Ian-Blockmans/efuse/aftbeeldingen/home_test_opstelling.png

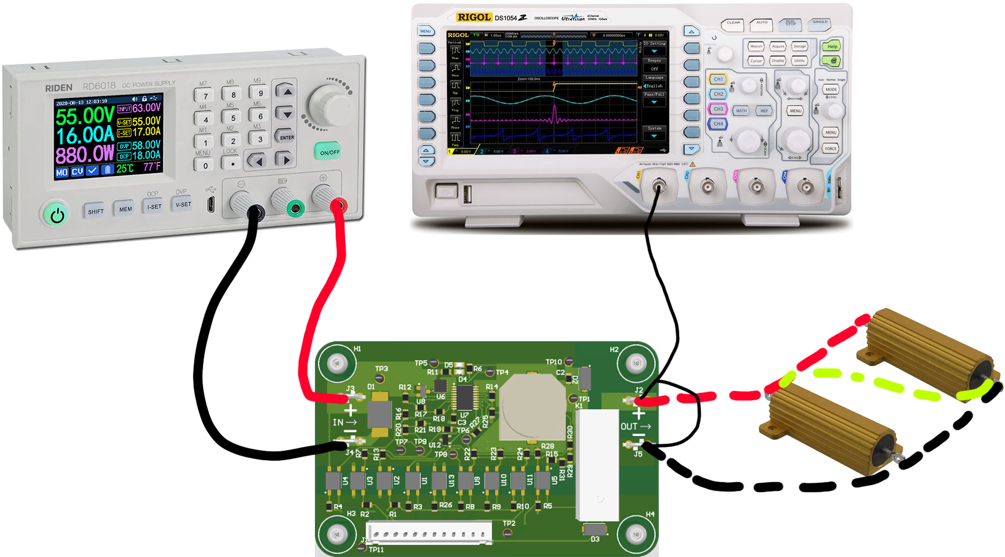
aftbeeldingen/home_test_opstelling.png
