Ian-Blockmans/efuse/aftbeeldingen/AS_test.png

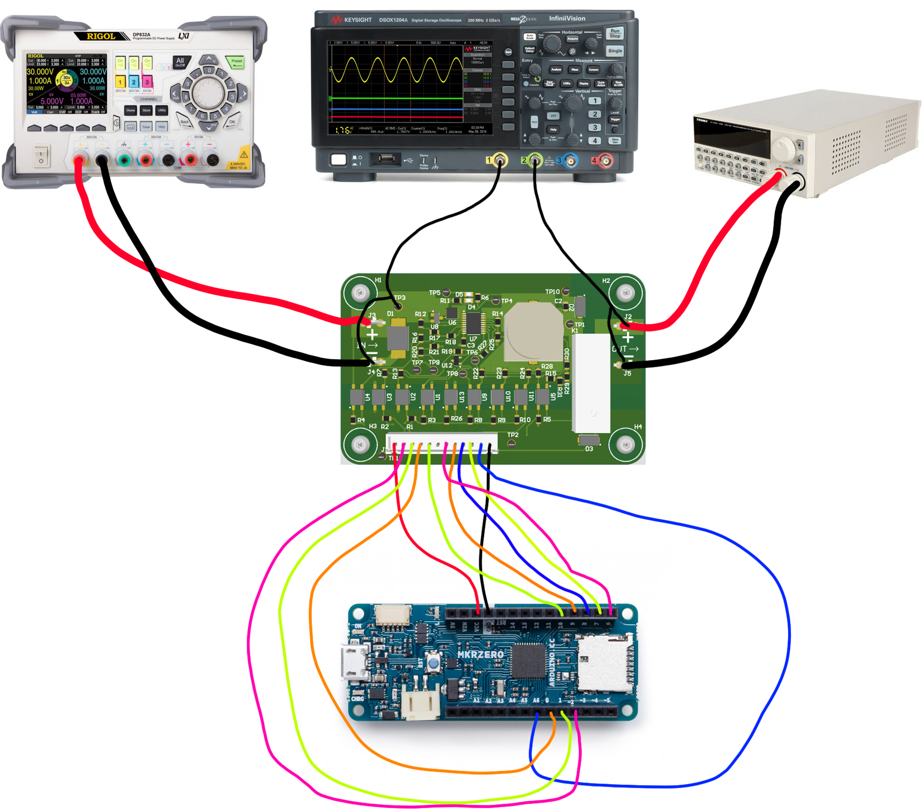
aftbeeldingen/AS_test.png
