Ian-Blockmans/efuse/README.md

# Bachelor proef: Efuse
Een second layer protection voor testopstellingen bij Antwerp Space. Zie Eindwerk-Ian-Blockmans-r0741829.pdf voor meer info
