Ian-Blockmans/efuse/efuse 2021.docx

# Voorwoord

Typ hier het voorwoord

# Samenvatting

# Inhoudstafel

# Inleiding

Typ hier de inleiding

# 1 blokschema

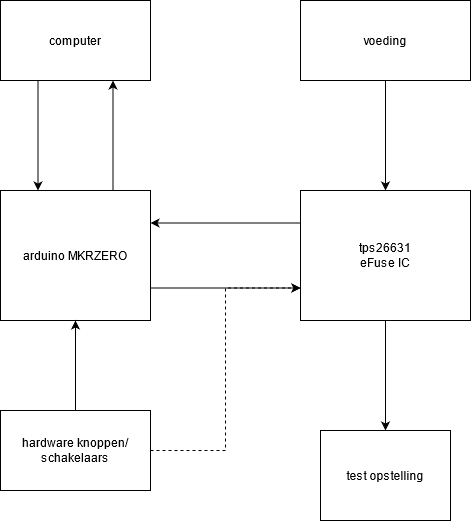
[picture p14: figure]

eFuse-LCL13

# 2 Software

## 2.1 IDE’s

Bruikbare IDE’s voor Atmel SAM (arduino mkrzero):

| Microchip MPLAB | PlatformIO | Arduino | IAR Embedded Workbench
Prijs | Gratis | Gratis | Gratis | Niet vermeld je moet een quote vragen
Editor | custom | VSCode, … | Custom(arduino ide 2 is bijna identiek aan VSCode) | Custom of Eclipse
Debugging | Ja | Ja | Alleen in V2 momenteel in beta | Ja
Unit Testing | Mogelijk maar niet veel documentie. | Ingeboud. Goede documentatie. | Mogelijk met extra software vooral voor arduino bordjes | Extern
Code Coverage | Ja | Extern | Extern | Extern
Open source | Nee | Ja | Ja | Nee
Extras | MPLAB Code Configurator(GUI controller configurator tool), microchip HAL library. | Support voor arduino en veel andere platforms en libraries. | Arduino libraries. | Functional safetey certificcation, …

Mijn keuze hier is PlatformIO. Heeft de meeste functionaliteit en is gratis.

## 2.2 User interface

### 2.2.1 Modbus over virtual com port

Voor communicatie met een computer is er gekozen voor Modbus RTU. Dit is een gestandaardiseerd protocol. Hierdoor kan ik gemakkelijk data van de eFuse binnen nemen en data sturen naar de eFuse.

#### 2.2.1.1 Coils

Adres | Coil name | Function
1 | ON/OFF | De efuse aan en uit zetten.
2 | LCL-class 1 | Maximumstroom 1.4A spanning van 22V tot 38V
3 | LCL-class 2 | Maximumstroom 2.8A spanning van 22V tot 38V
4 | LCL-class 3 | Maximumstroom 4.2A spanning van 22V tot 38V
5 | 12V | Maximum spanning 12V
6 | 5V | Maximum spanning 5V
7 | Arduino led | Led van de arduino

Als een LCL-class coil op 1 wordt gezet worden de andere op 0 gezet. Als je een instelling op 0 zet wordt de efuse uitgeschakeld.

#### 2.2.1.2 Registers

… temprature?

#### 2.2.1.3 Inputs

Adres | Input name | Function
1 | Pgood | Is de eFuse ON
2 | Fault | Er is een fout opgetreden (overvolt, undervolt of overcurrent)

#### 2.2.1.4 Finite state machine modbus

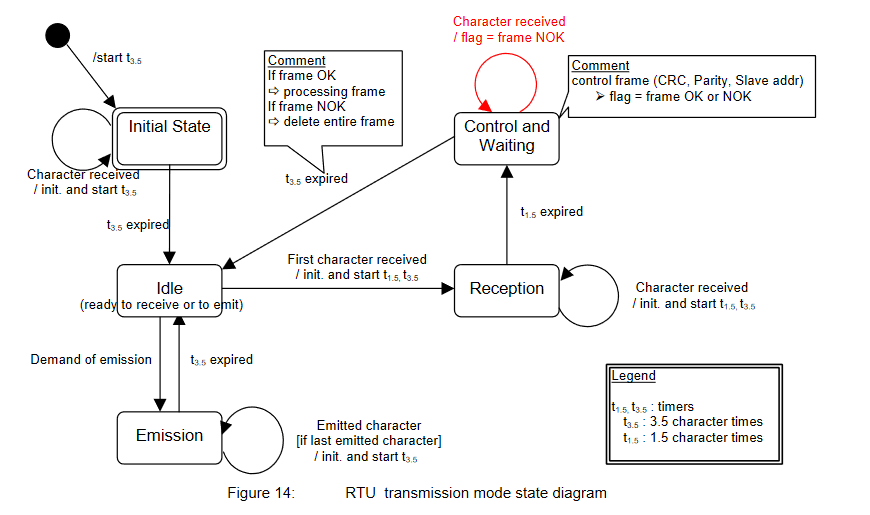
[picture p15: figure]

#### 2.2.1.5 Control and wait flowchart

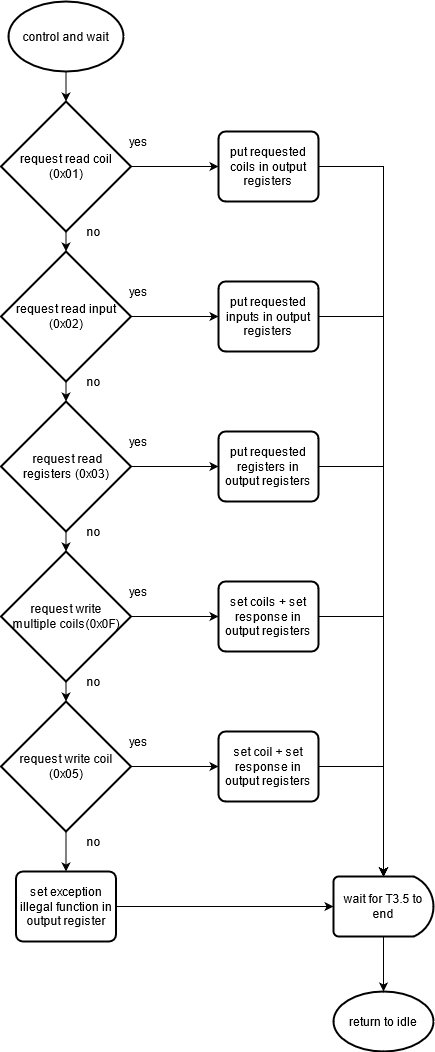
[picture p16: figure]

# 3 Hardware

## 3.1 Component keuze

### 3.1.1 eFuse

eFuse | ST stef01 | TI tps2660x | TI tps2663x
Voltage range | 8 to 48V | 4.2 to 60V | 4.5 to 60V
Continuous current | 4A | 2.23A | 6A
Max curren | 6A | N/A | N/A
Parallel theoretisch moglijk | Ja | Ja | Ja
Prijs | 2euro | = | 3euro
Reverse ploarity protection | Externe fet | Intern | Externe fet
Piek stroom | N/A | 3x limiet gemeten | 2x limiet gedefinieerd in de datasheet

De tps2660 ic is het meest kost effectief. Zou genoeg zijn voor een class 1 of 2 voeding maar heeft geen overhead. Bij LCL-klasse 2 zit je aan de minimumstroom limiet.

De STEF01 is goedkoop voor wat hij aan kan maar door mijn slechte ervaring en de enkele bi directionele fout pin is het moeilijk om deze aan te raden. Kan LCL-klasse 3 maar de 5V instelling of lager gaat niet.

De tps2663 is duurder maar heeft hogere limieten dan de andere. Deze ic kan het meesten inclusief klasse 3 en 5V.

Een 3.3V instelling is niet belangrijk dus deze komt er niet bij.

De gekozen ic is de TPS26631 deze laat hogere piek stromen toe en is geschikt voor de toepassing.

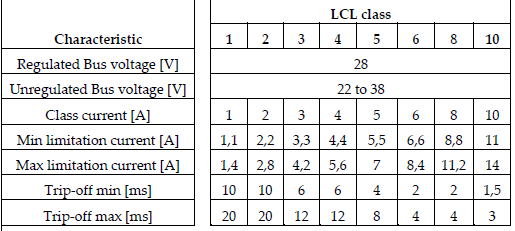
[picture p17: figure]

### 3.1.2 ESD en overspanning beveiliging

#### 3.1.2.1 Ingang

Op de ingang gebruik ik een bi-directionele TVS-diode. Deze zijn meer gebruikt bij lage spanningen. Er is geen extra fuse nodig omdat deze “open” breken, kan een voordeel zijn. Ze gaan ook langer mee.

#### 3.1.2.2 Uitgang

Op de uitgang heb ik een shotkey diode voor ESD protection.

## 3.2 eFuse TPS26631

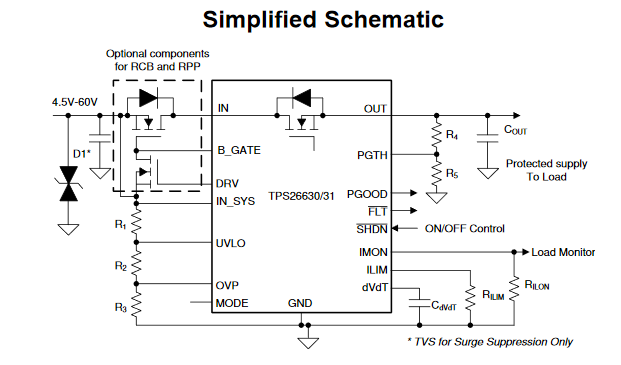
[picture p18: figure]

### 3.2.1 Spanning limiet instellingen

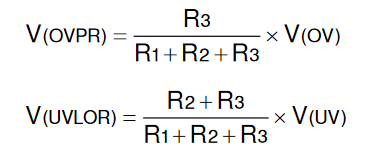
[picture p19: figure]

In specs: V(OVPR)= 1.2 V and V(UVLOR)= 1.2 V

#### 3.2.1.1 LCL-classes

LCL-classes definiëren een spanning tussen 22 en 38V.

R3 = 36kΩ

1.2V=(36000Ω)/(R1+R2+36000Ω)*38V

R1+R2=((36000Ω)/(1.2V)*38V)-36000Ω=1104000Ω

R2=((1.2V*(1104000Ω+36000Ω))/(22V))-36000Ω=26181.81818Ω

R1=(((26182Ω+36000Ω)/(1.2V))*22V)-26182Ω-36000Ω=1077821.333Ω

Bestaande enkele weerstanden E24: 1M+75K,27K,36K

V(ov)=1.2V*((1075000Ω+27000Ω+36000Ω)/(36000Ω))=37.933V

V(uv)=1.2V*((1075000Ω+27000Ω+36000Ω)/(27000Ω+36000Ω))=21.67V

Bestaande enkele weerstanden alternatief 1 E24: 1M+75K,24K,36K

V(ov)=1.2V*((1075000Ω+24000Ω+36000Ω)/(36000Ω))=37.83V

V(uv)=1.2V*((1075000Ω+24000Ω+36000Ω)/(24000Ω+36000Ω))=22.7V

Bestaande enkele weerstanden alternatief 2

R3 = 33kΩ

1.2V=(33000Ω)/(R1+R2+33000Ω)*38V

R1+R2=((33000Ω)/(1.2V)*38V)-33000Ω=1012000Ω

R2=((1.2V*(1012000Ω+33000Ω))/(22V))-33000Ω=24000Ω

R1=(((24000Ω+33000Ω)/(1.2V))*22V)-24000Ω-33000Ω=988000Ω

E24: 1M,24K,33K

V(ov)=1.2V*((1000000Ω+24000Ω+33000Ω)/(33000Ω))=38.4V

V(uv)=1.2V*((1000000Ω+24000Ω+33000Ω)/(24000Ω+33000Ω))=22.25V

Bestaande enkele weerstanden alternatief 3 E12: 1M,22K,33K

V(ov)=1.2V*((1000000Ω+22000Ω+33000Ω)/(33000Ω))=38.36V

V(uv)=1.2V*((1000000Ω+22000Ω+33000Ω)/(24000Ω+33000Ω))=23V

Bestaande enkele weerstanden alternatief 3 E12: 910k+75k,24K,33K

V(ov)=1.2V*((985000Ω+24000Ω+33000Ω)/(33000Ω))=37.9V

V(uv)=1.2V*((985000Ω+24000Ω+33000Ω)/(24000Ω+33000Ω))=21.94V

Bestaande enkele weerstanden alternatief finall recommended E24: 910k+75k,24K,51K//91k=32683

V(ov)=1.2V*((985000Ω+24000Ω+32683Ω)/(32683Ω))=38.25V

V(uv)=1.2V*((985000Ω+24000Ω+32683Ω)/(24000Ω+32683Ω))=22.05V

#### 3.2.1.2 Extra instelpunten

12V:

R3 = 33kΩ

1.2V=(33000Ω)/(R1+R2+33000Ω)*12V

R1+R2=((33000Ω)/(1.2V)*12V)-33000Ω=297000Ω

R2=((1.2V*(297000Ω+33000Ω))/(11V))-33000Ω=3000Ω

R1=(((3000Ω+33000Ω)/(1.2V))*11V)-3000Ω-33000Ω=294000Ω

Bestaande enkele weerstanden E24 985k//430k,24k,51K//91k:

V(ov)=1.2V*((300000Ω+24000Ω+33000Ω)/(33000Ω))=13V

V(uv)=1.2V*((300000Ω+24000Ω+33000Ω)/(24000Ω+33000Ω))=7.5V

5V:

Bestaande enkele weerstanden E24 985k//430k,24k,91k:

V(ov)=1.2V*((300000Ω+24000Ω+91000Ω)/(91000Ω))=5.4V

V(uv)=1.2V*((300000Ω+24000Ω+91000Ω)/(24000Ω+91000Ω))=4.3→4.5V

### 3.2.2 Stroom limiet instellingen

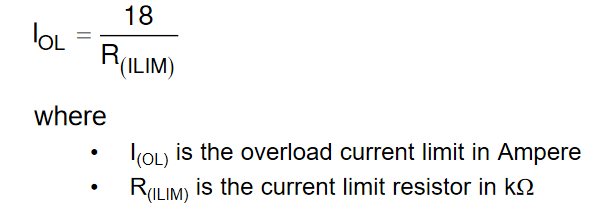
[picture p20: figure]

#### 3.2.2.1 Class1

IOL=1.4A

18/(1.4A)=12.8kΩ

Bestaande weerstand -> 13k Ω

18/13=1.38A

#### 3.2.2.2 Class 2

IOL=2.8A

18/(2.8A)=6.4kΩ

Bestaande weerstand -> 6.8k Ω

18/6.8=2.65A

#### 3.2.2.3 Class 3

IOL=4.2A

18/(4.2A)=4.28kΩ

Bestaande weerstand -> 4.3k Ω

18/4.3=4.18A

### 3.2.3 Power Good

((22V)/(1.14V)*56kΩ)-56kΩ=1MΩ

## 3.3 Optocoupler voorschakel weerstand

#### 3.3.1.1 eFuse kant

Led 1.3V @ 5mA

mid -> 22V ->22V-1.3V=20.7V→(20.7V)/(5mA)=4140Ω

Bestaande weerstand: 4.3kΩ

max→ 60V →60/(4300Ω)=14mA

min→ 5V →5/(4300Ω)=1.2mA

38/0.06 = 633.33ohm current limit analog opto coupler

#### 3.3.1.2 Digitale kant

Led 1.3V @ 5mA

mid -> 3.3V ->3.3V-1.3V=2V→(2V)/(5mA)=400Ω

Bestaande weerstand: 390Ω

## 3.4 Prototype

Een prototype is gemaakt met alle minimum functionaliteit.

- LCL-klasse 1,2 en 3.
- Output relay.
- Spanning instelling voor 5V,12V en 22V tot 38V.
- Aanstuur baar met headers

### 3.4.1 Pinout header

1. GND
2. Relay
3. Ilim 4.2A
4. Ilim 2.8A
5. Ilim 1.4A
6. Ovp_s pull down voor 12V of 22V tot 38V
7. Imon niet gebruikt
8. SHDN pull down voor shutdown
9. Fault output
10. Pgood output
11. Uvp_s pull down voor 12V of 5V
12. 3.3V

### 3.4.2 Schema’s

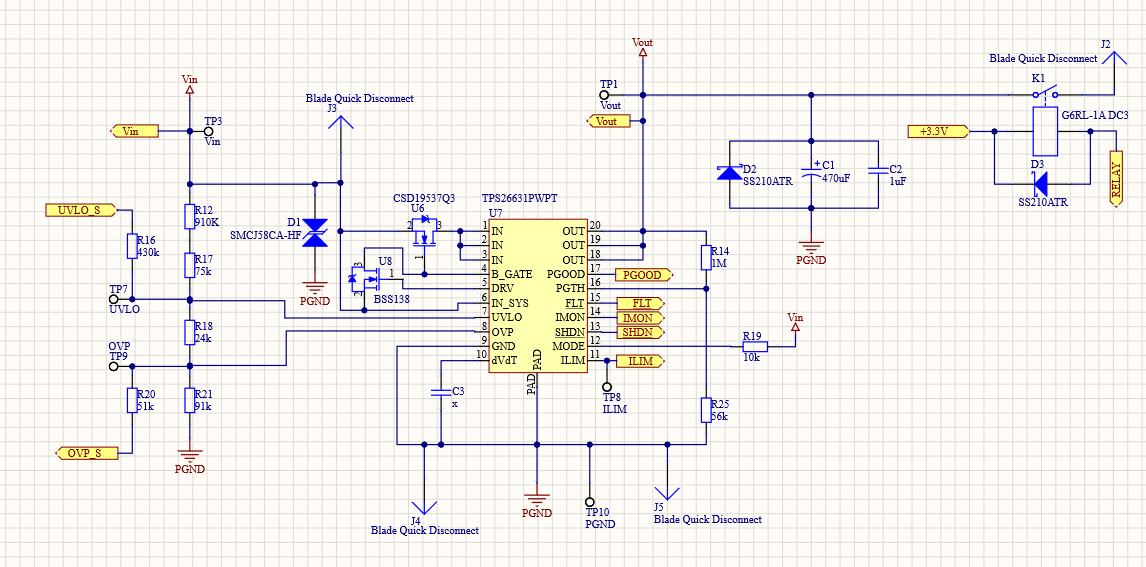
[picture p21: figure]
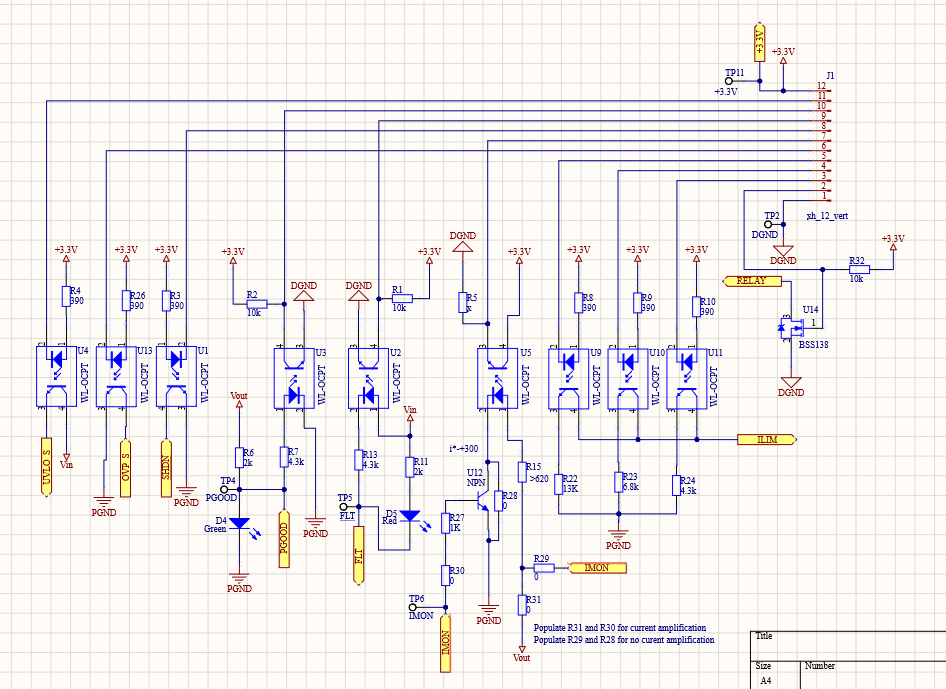
[picture p22: figure]

### 3.4.3 PCB

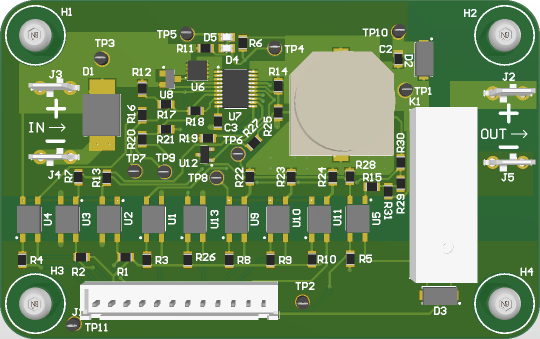
[picture p23: figure]
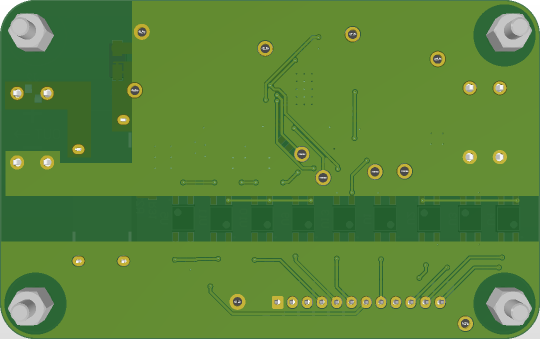
[picture p24: figure]

### 3.4.4 Tests

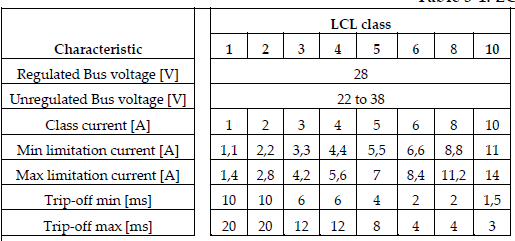
[picture p25: figure]

#### 3.4.4.1 Spannings punten

Instelling | Overvolt protection | Undervolt protection
LCL-Klasse | 37.78V | 20.43V
12V | 14.46V | 10.71V
5V | 5.45V | 4.2V (no fault but lower limit efuse ic)

#### 3.4.4.2 Stroom limiet

Instelling | Sroom limiet
LCL-Klasse 1 | ±1.35A
LCL-Klasse 2 | ±2.8A
LCL-Klasse 3 | ±4.2A

#### 3.4.4.3 Afschakel snelheid

instelling | Tijd


LCL-klasse | 770µs met microcontroller relai uitschakelen no load 8.8ms met max sroom. Als er een lichte load aan hangt word deze tijd uit gerekt. Deze meeting is gedaan met een 100µF condensator en een weerstand van 26Ohm 4ms Met de relai uitschakelen 26Ohm
12V | 4.5ms met load en relai


5V | 4.7ms met load en relai

# besluit….

Typ hier je besluit

# Literatuurlijst
