Ian-Blockmans/efuse/overige documenten/tusentijdse presentatie.pptx

## Efuse

Antwerp Space

## Wat is een efuse

- Voltage limit
- Under voltage dropout
- Current limit
- Reverse polarization protection
- Soft start
- ON/OFF switching
- Current monitoring

## doel

- Extra laag veiligheid
- Gemaakt naar voedingen met LCL klasse 1,2 en 3.
- Mogelijkheid voor 5V, 12V en 22V tot 38V

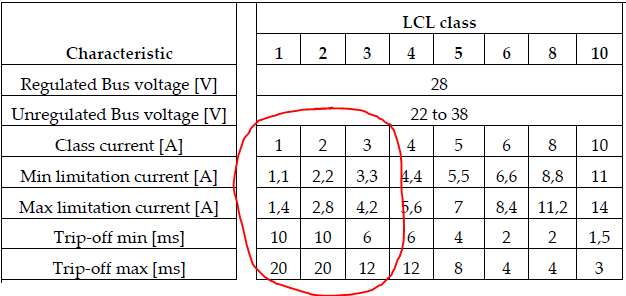
[picture p26: figure]

## Planning

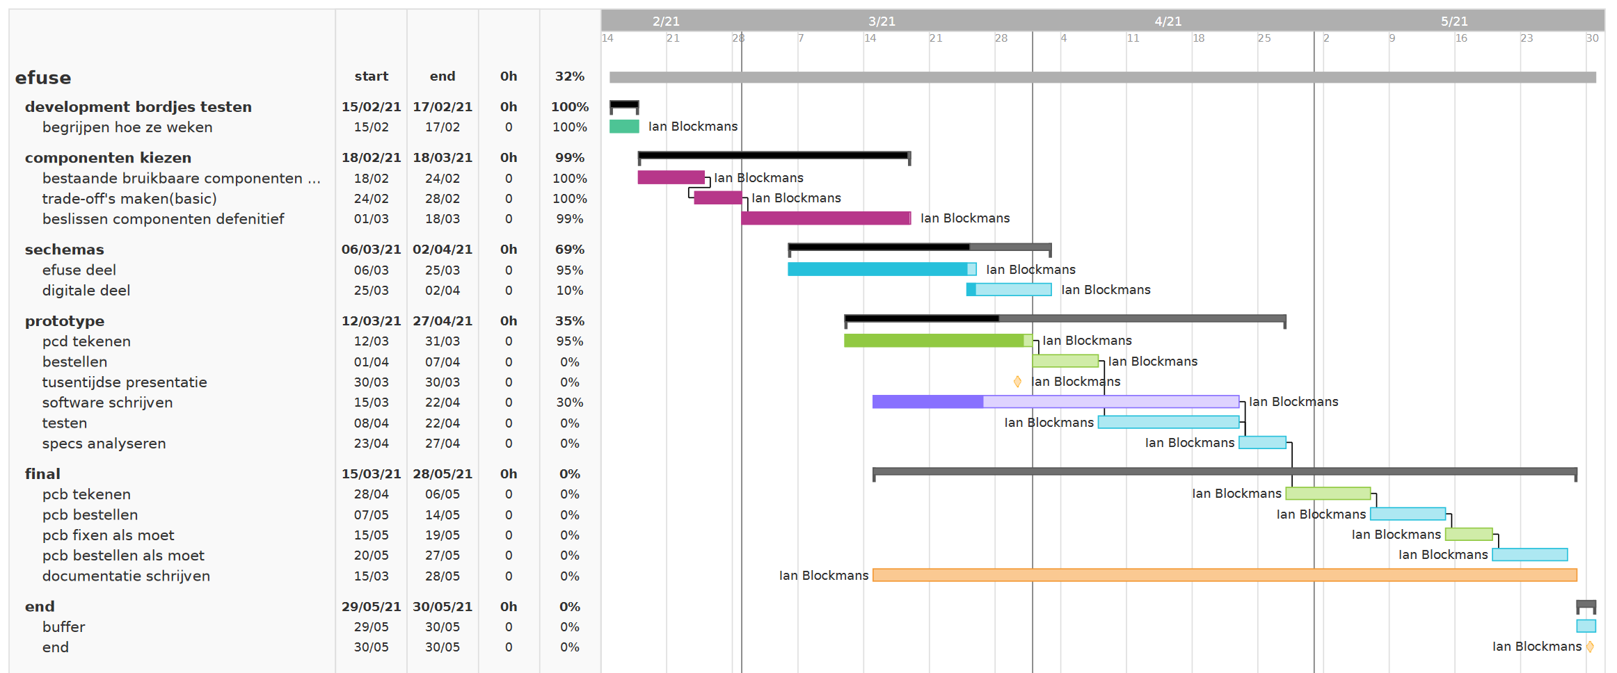
[picture p27: figure]

## INput

- Instellen van voltage limits.
- Transient voltage protection.
- Reverse polarity protection.
- Inrush current control.

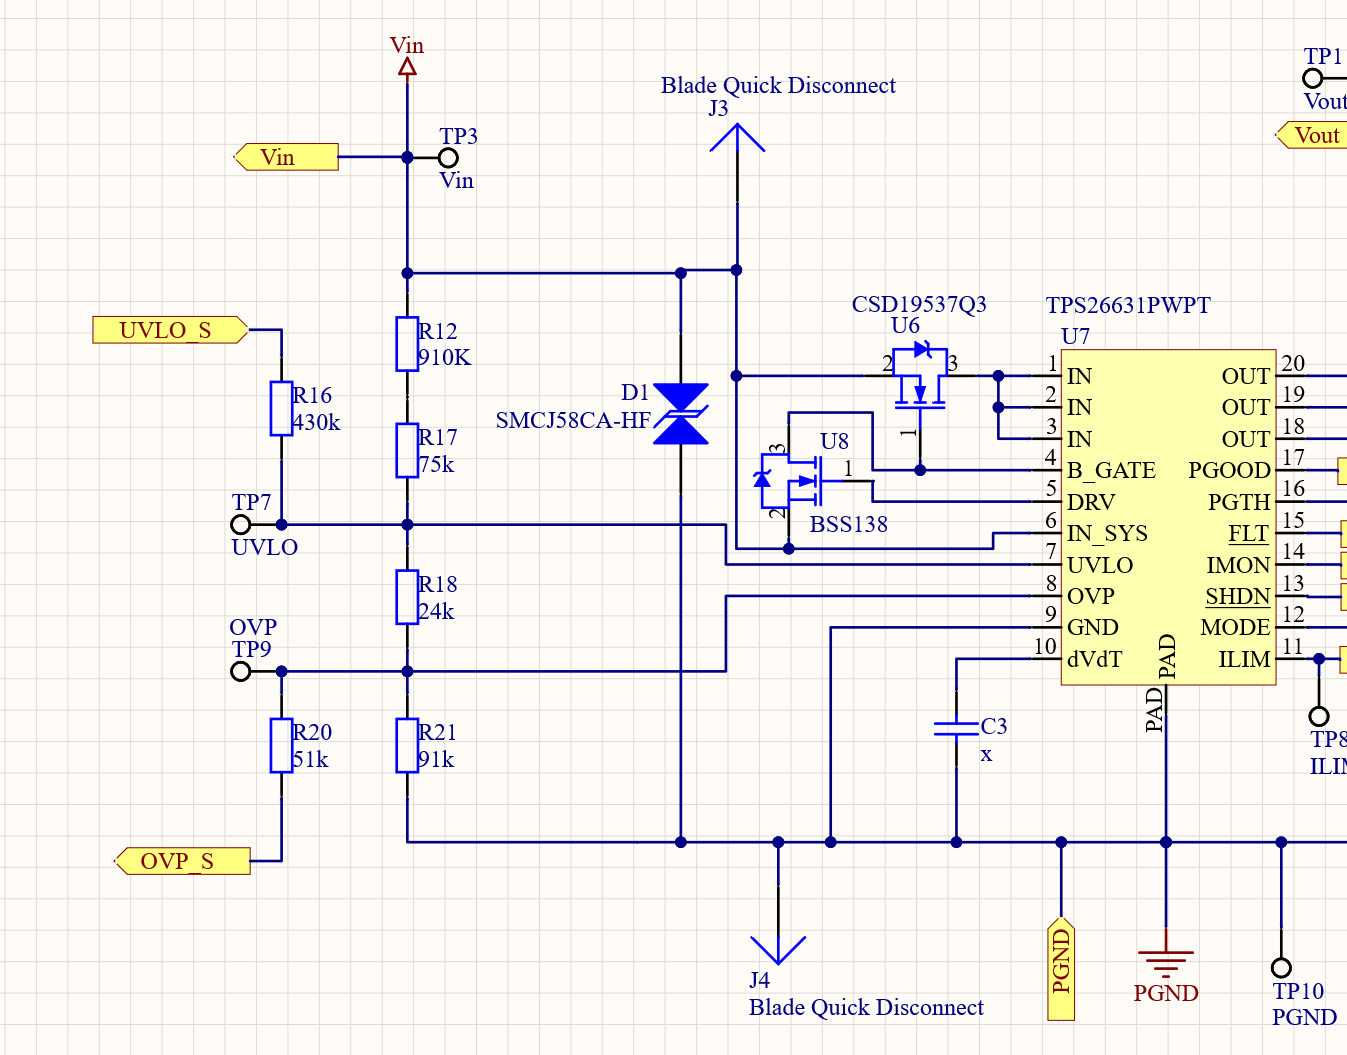
[picture p28: figure]

## output

- Power Good instelling.
- ESD protection.
- Mode/auto retry
- Output relay

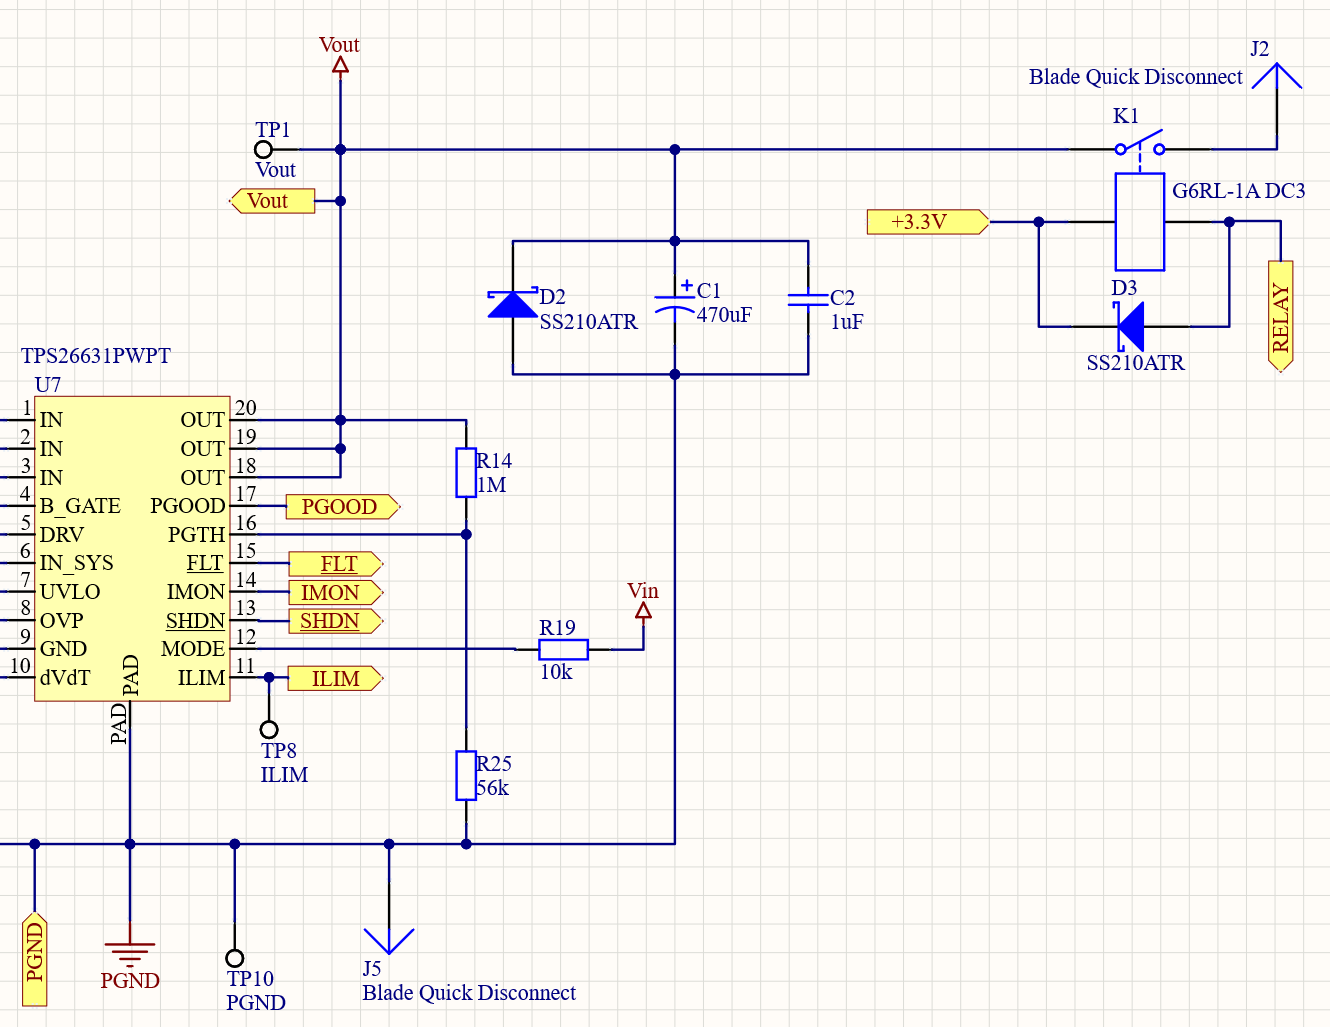
[picture p29: figure]

## Digital

- Galvanisch gescheiden.
- Indicatie leds.
- Stroom meting.
- Stroom limiet.

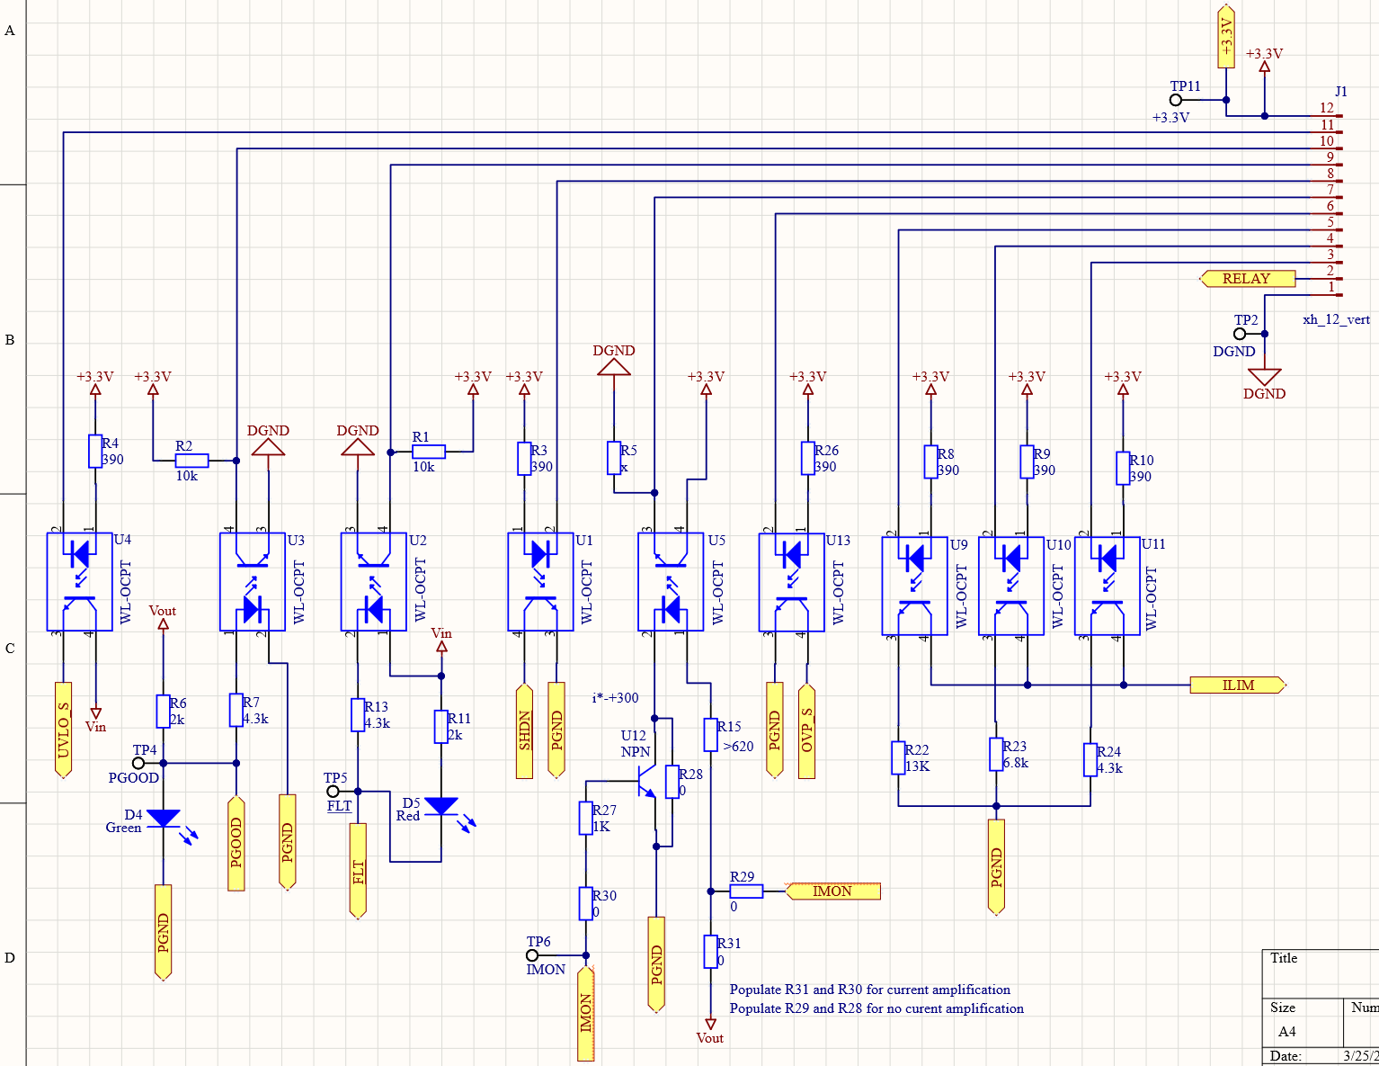
[picture p30: figure]

## User input en feedback

- Oled display
- joystick of rotary encoder
- USB Modbus -> LabView

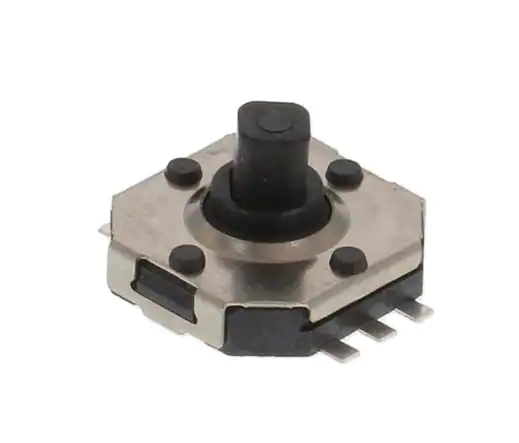
[picture p31: figure]
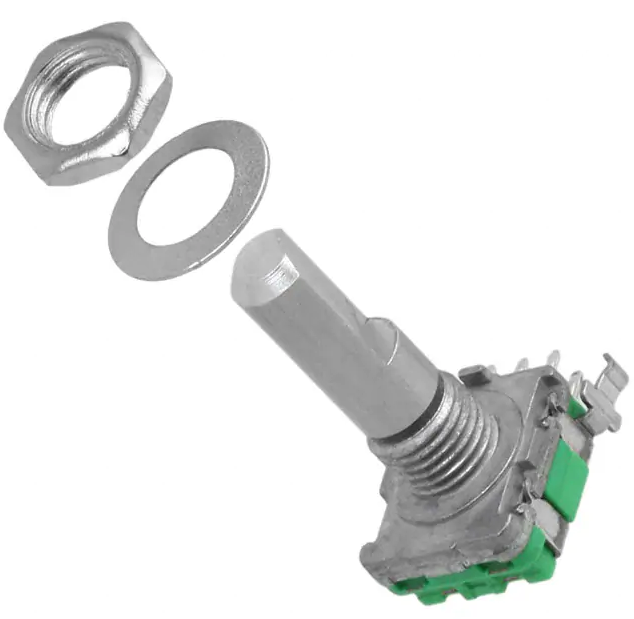
[picture p32: figure]
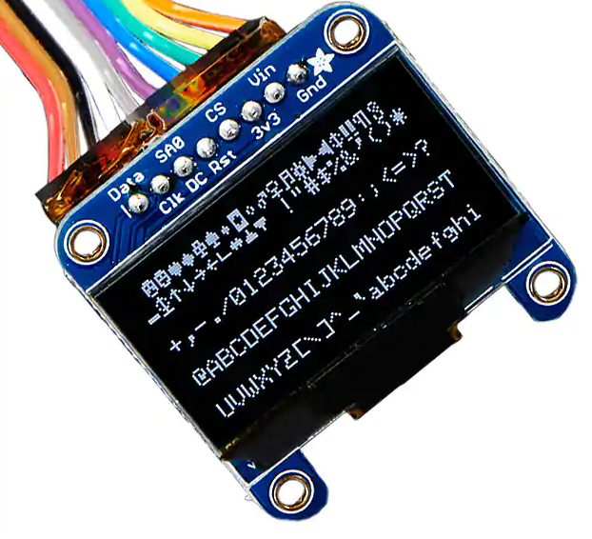
[picture p33: figure]

## Prototype pcb


## Vragen?
