Ian-Blockmans/efuse/overige documenten/efuse planning rev.2 07-03-21.pdf

14 | 21 | 28 | 7 | 14 | 21 | 28 | 4 | 11 | 18 | 25 | 2 | 9 | 16 | 23 | 30
2/21 | 3/21 | 4/21 | 5/21
efuse | start | end | 0h | 12%
development bordjes testen | 15/02/21 17/02/21 | 0h | 100%
begrijpen hoe ze weken | 15/02 | 17/02 | 0 | 100%
componenten kiezen | 18/02/21 12/03/21 | 0h | 90%
bestaande bruikbaare componenten ... | 18/02 | 24/02 | 0 | 100%
trade-off's maken(basic) | 24/02 | 28/02 | 0 | 100%
beslissen componenten defenitief | 01/03 | 12/03 | 0 | 80%
sechemas | 06/03/21 19/03/21 | 0h | 15%
efuse deel | 06/03 | 12/03 | 0 | 30%
digitale deel | 13/03 | 19/03 | 0 | 0%
prototype | 13/03/21 18/04/21 | 0h | 0%
pcd tekenen | 13/03 | 19/03 | 0 | 0%
pcb bestellen als er tijd is | 20/03 | 31/03 | 0 | 0%
pcb frezen als er minder tijd is | 24/03 | 24/03 | 0 | 0%
componenten bestellen | 13/03 | 19/03 | 0 | 0%
software schrijven | 20/03 | 14/04 | 0 | 0%
testen | 01/04 | 14/04 | 0 | 0%
specs analyseren | 15/04 | 18/04 | 0 | 0%
final | 20/03/21 28/05/21 | 0h | 0%
pcb tekenen | 19/04 | 27/04 | 0 | 0%
pcb bestellen | 28/04 | 05/05 | 0 | 0%
pcb fixen als moet | 06/05 | 10/05 | 0 | 0%
pcb bestellen als moet | 11/05 | 18/05 | 0 | 0%
documentatie schrijven | 20/03 | 28/05 | 0 | 0%
end | 29/05/21 30/05/21 | 0h | 0%
buffer | 29/05 | 30/05 | 0 | 0%
end | 30/05 | 30/05 | 0 | 0%

Ian Blockmans

Ian Blockmans
Ian Blockmans
Ian Blockmans

Ian Blockmans
Ian Blockmans

Ian Blockmans
Ian Blockmans
Ian Blockmans
Ian Blockmans
Ian Blockmans

Ian Blockmans

Ian Blockmans

Ian Blockmans

Ian Blockmans

Ian Blockmans

Powered by TCPDF (www.tcpdf.org)
