Ian-Blockmans/efuse/pcb/controller.png

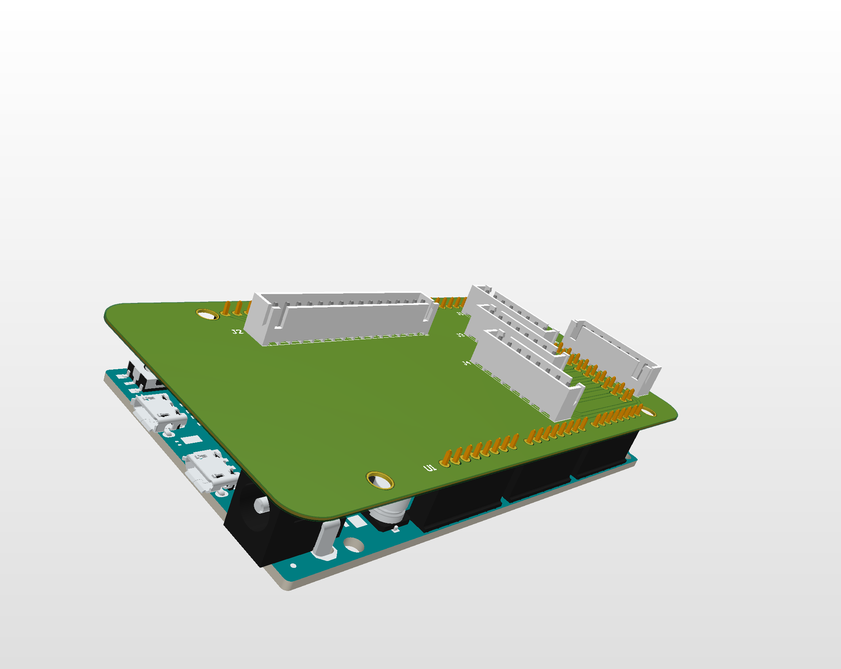
pcb/controller.png
