Ian-Blockmans/efuse/pcb/efuseV0.2_top.png

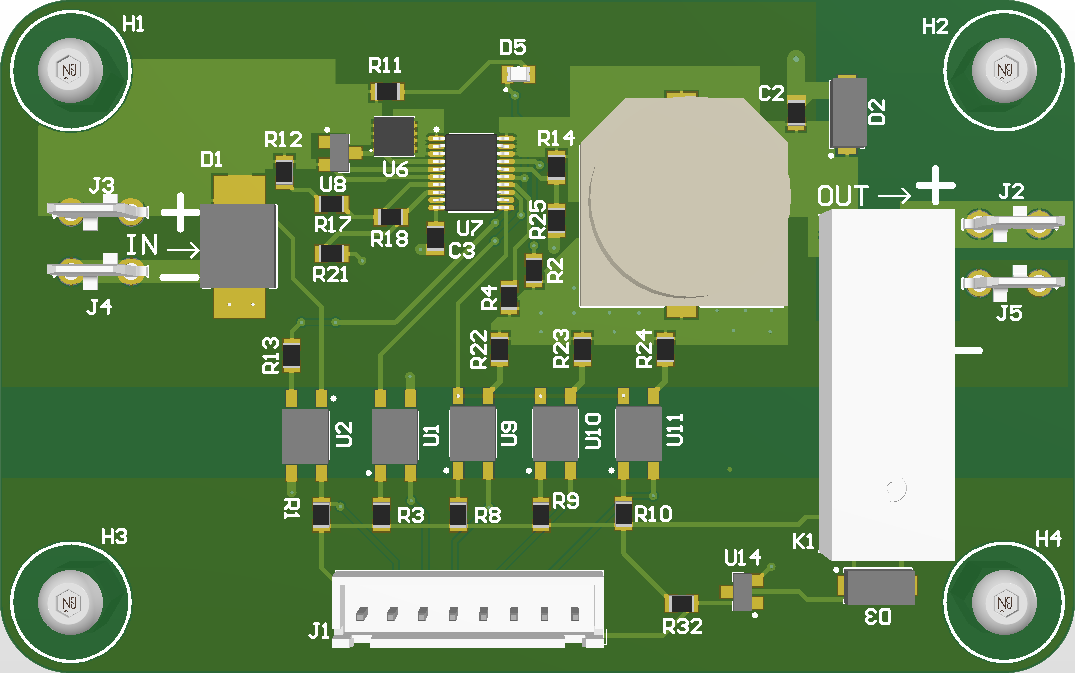
pcb/efuseV0.2_top.png
