Ian-Blockmans/efuse/pcb/front pannel.png

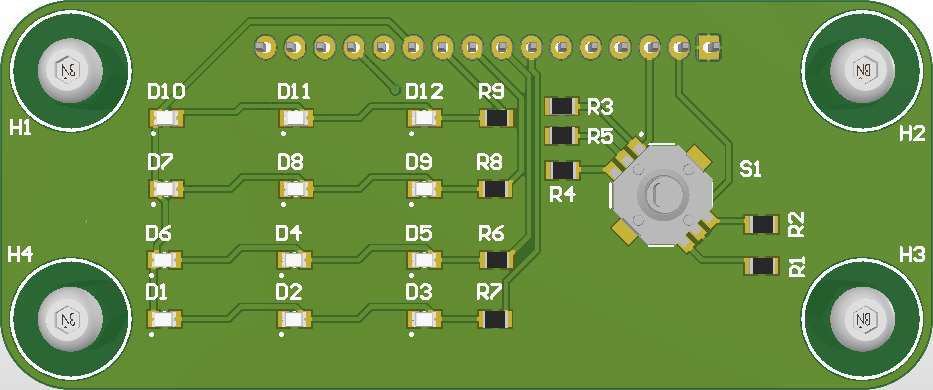
pcb/front pannel.png
