Ian-Blockmans/efuse/overige documenten/Bom_eFuse.pdf

Onderdeelnr. fabrikant | Fabrikant | Onderdeelnummer Digi‐Key Status onderdeel Aantal Eenheidsprijs Totale kostprijs | Beschikbare hoeveelheid | Beschrijving
TPS26631PWPR | Texas Instruments | 296‐TPS26631PWPRCT‐ND | Active | 5 3,13000 | 15,65 € | 2169 4.5V ‐ 60V 6A 29MOHM EFUSE
140356145400 | Würth Elektronik | 732‐140356145400CT‐ND | Active | 20 0,26600 | 5,32 € | 2980 WL‐OCPT OPTOCOUPLER PHOTOTRANSIS
1217861‐1 | TE Connectivity AMP Connectors | A100452CT‐ND | Active | 25 0,05880 | 1,47 € | 274159 CONN QC TAB 0.250 SOLDER
ESR10EZPJ133 | Rohm Semiconductor | RHM13KKCT‐ND | Active | 20 0,06800 | 1,36 € | 11073 RES SMD 13K OHM 5% 0.4W 0805
ERJ‐P06J432V | Panasonic Electronic Components | P4.3KADCT‐ND | Active | 20 0,08900 | 1,78 € | 1215 RES SMD 4.3K OHM 5% 1/2W 0805
ERJ‐P06J682V | Panasonic Electronic Components | P6.8KADCT‐ND | Active | 20 0,08900 | 1,78 € | 7062 RES SMD 6.8K OHM 5% 1/2W 0805
RNCP0805FTD750R | Stackpole Electronics Inc | RNCP0805FTD750RCT‐ND | Active | 20 0,05800 | 1,16 € | 17646 RES 750 OHM 1% 1/4W 0805
RNCP0805FTD10K0 | Stackpole Electronics Inc | RNCP0805FTD10K0CT‐ND | Active | 20 0,05800 | 1,16 € | 118686 RES 10K OHM 1% 1/4W 0805
ERJ‐6ENF1004V | Panasonic Electronic Components | P1.00MCCT‐ND | Active | 20 0,06200 | 1,24 € | 28592 RES SMD 1M OHM 1% 1/8W 0805
ERJ‐6ENF5602V | Panasonic Electronic Components | P56.0KCCT‐ND | Active | 20 0,06200 | 1,24 € | 42407 RES SMD 56K OHM 1% 1/8W 0805
ERJ‐6ENF9103V | Panasonic Electronic Components | P910KCCT‐ND | Active | 20 0,06200 | 1,24 € | 84715 RES SMD 910K OHM 1% 1/8W 0805
ERJ‐6ENF4303V | Panasonic Electronic Components | P430KCCT‐ND | Active | 20 0,06200 | 1,24 € | 49378 RES SMD 430K OHM 1% 1/8W 0805
ERJ‐6ENF7502V | Panasonic Electronic Components | P75.0KCCT‐ND | Active | 20 0,06200 | 1,24 € | 13161 RES SMD 75K OHM 1% 1/8W 0805
ERJ‐6ENF2402V | Panasonic Electronic Components | P24.0KCCT‐ND | Active | 20 0,06200 | 1,24 € | 3853 RES SMD 24K OHM 1% 1/8W 0805
ERJ‐6ENF5102V | Panasonic Electronic Components | P51.0KCCT‐ND | Active | 10 0,06200 | 0,62 € | 1536 RES SMD 51K OHM 1% 1/8W 0805
ERJ‐6ENF9102V | Panasonic Electronic Components | P91.0KCCT‐ND | Active | 20 0,06400 | 1,28 € | 449 RES SMD 91K OHM 1% 1/8W 0805
CSD19537Q3 | Texas Instruments | 296‐44351‐1‐ND | Active | 5 1,15000 | 5,75 € | 3457 MOSFET N‐CH 100V 9.7A/50A 8VSON
BSS138 | ON Semiconductor | BSS138CT‐ND | Active | 5 0,22000 | 1,10 € | 1072 MOSFET N‐CH 50V 220MA SOT23‐3
SMCJ58CA‐HF | Comchip Technology | 641‐2114‐1‐ND | Active | 5 0,49000 | 2,45 € | 2997 DIODE TVS 58V 1500W SMC BI‐DIR
EEE‐HA1J470UP | Panasonic Electronic Components | PCE4233CT‐ND | Active | 5 0,54000 | 2,70 € | 75129 CAP ALUM 47UF 20% 63V SMD
CGA4J3X7S2A105M125AE TDK Corporation | 445‐7961‐1‐ND | Active | 10 0,26100 | 2,61 € | 57651 CAP CER 1UF 100V X7S 0805
SS210ATR | SMC Diode Solutions | 1655‐1896‐1‐ND | Active | 10 0,14400 | 1,44 € | 14662 DIODE SCHOTTKY 100V 2A SMA
5281 | Keystone Electronics | 36‐5281‐ND | Active | 25 0,21400 | 5,35 € | 3824 TEST POINT (BLACK) ‐ MULTIPURPOS
LTST‐C171GKT | Lite‐On Inc. | 160‐1423‐1‐ND | Active | 10 0,11600 | 1,16 € | 138573 LED GREEN CLEAR CHIP SMD
LH R974‐LP‐1 | OSRAM Opto Semiconductors Inc. | 475‐1415‐1‐ND | Active | 10 0,11500 | 1,15 € | 31149 LED RED DIFFUSED 0805 SMD
BC817‐40,235 | Nexperia USA Inc. | 1727‐6186‐1‐ND | Active | 5 0,11000 | 0,55 € | 1506 TRANS NPN 45V 500MA TO236AB
G6RL‐1A DC3 | Omron Electronics Inc‐EMC Div | Z2762‐ND | Active | 3 3,46000 | 10,38 € | 325 RELAY GEN PURPOSE SPST 10A 3V
ERJ‐6GEYJ202V | Panasonic Electronic Components | P2.0KACT‐ND | Active | 20 0,04700 | 0,94 € | 67296 RES SMD 2K OHM 5% 1/8W 0805
ERJ‐6GEY0R00V | Panasonic Electronic Components | P0.0ACT‐ND | Active | 100 0,01660 | 1,66 € | 513 RES SMD 0 OHM JUMPER 1/8W 0805
938 | Adafruit Industries LLC | 1528‐1512‐ND | Active | 2 16,46000 | 32,92 € | 1118 MONOCHROME 1.3 128X64
TMP411BDGKR | Texas Instruments | 296‐21418‐6‐ND | Active | 5 2,29000 | 11,45 € | 1159 SENSOR DIGITAL ‐40C‐125C 8VSSOP
EN11‐VSM1AF20 | TT Electronics/BI | 987‐1192‐ND | Active | 2 0,97000 | 1,94 € | 2067 ROTARY ENCODER MECHANICAL 20PPR
JS5208 | E‐Switch | EG4561‐ND | Active | 2 2,07000 | 4,14 € | 676 SWITCH NAVIGATION 20MA 15V
