Ian-Blockmans/efuse/overige documenten/eFuse_proto1.step

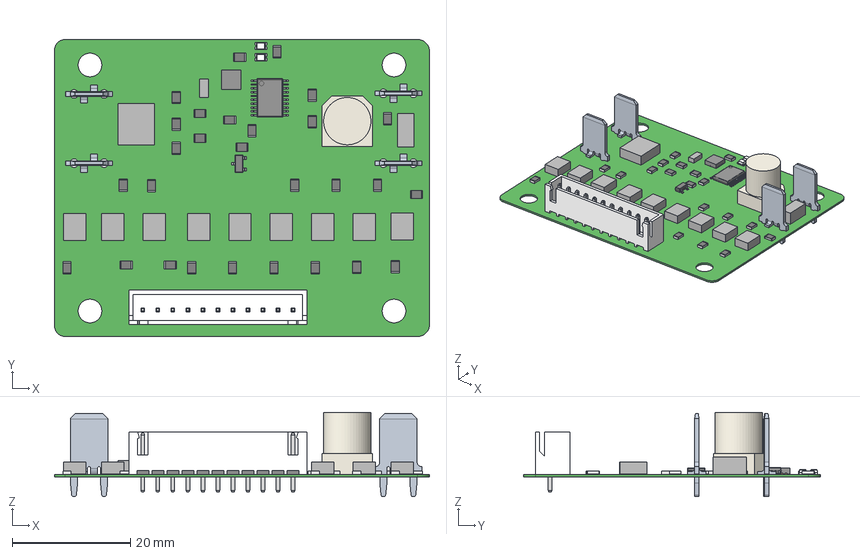
[picture p80: CAD file, 2021-03-13]
overige documenten/eFuse_proto1.step
63.4 x 50.2 x 14.3 mm
JST_-_XH_-_Thru_(V)_-_11Pin_-_2.54mm
Extruded x 13
Mid_Body x 28
Open_CASCADE_STEP_translator_6.8_2.2.1 x 56
Mark x 28
BODY-TSSOP
LEAD-TSSOP x 20
PIN1
DAP
BODY-SON
PIN1-ID
Open_CASCADE_STEP_translator_6.8_2.1.1
Leader x 3
0805_Chip_SMD_LED_(2x1.2mm) x 2
