Ian-Blockmans/efuse/overige documenten/Schematic Prints.pdf

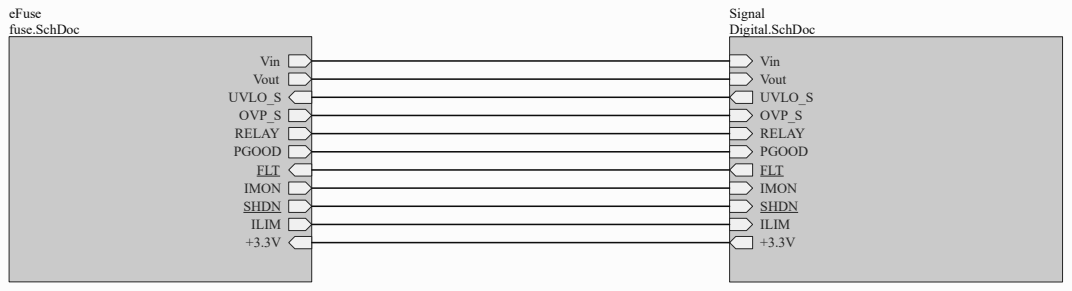
[picture p82: page 1]
Title; Vin; UVLO_S OVP_S RELAY PGOOD FLT IMON SHDN ILIM; Vout; eFuse fuse.SchDoc; Signal Digital.SchDoc

Size A4 | Number | Revision

Date: 4/07/2021 | Sheet of
File: F:\github\efuse\pcb\efuse\top.SchDoc | Drawn By:

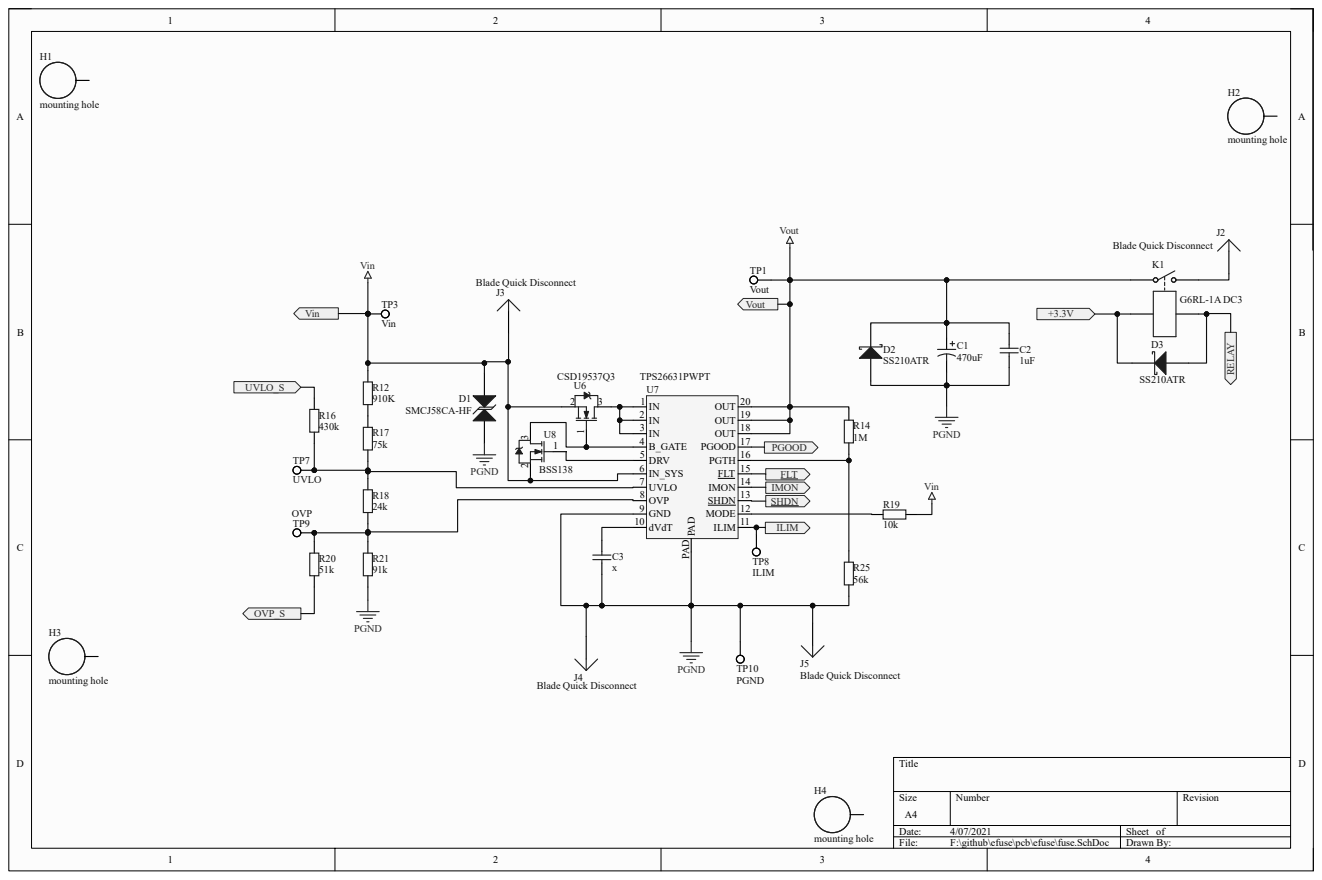
[picture p83: page 2]

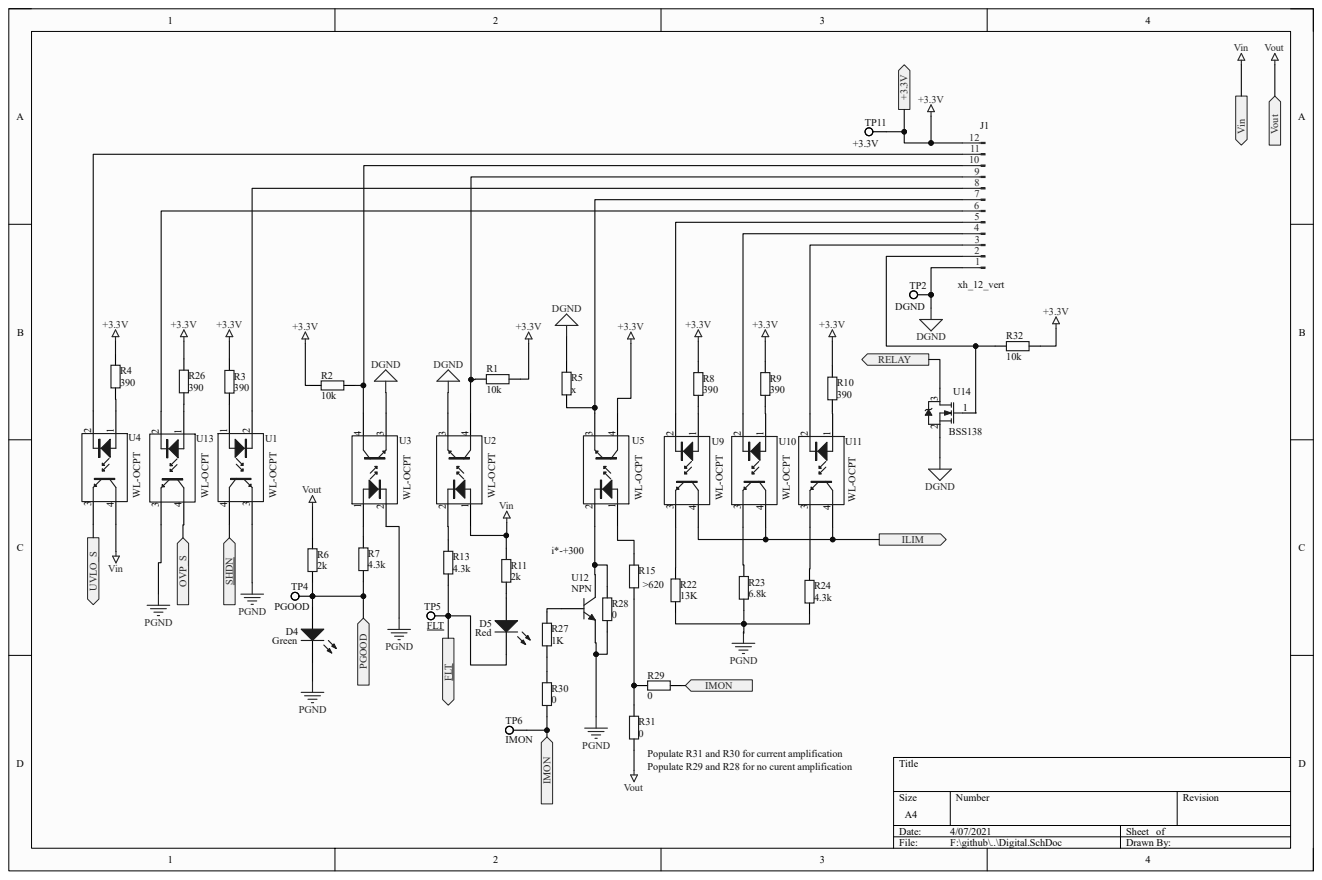
[picture p84: page 3]

Populate R31 and R30 for current amplification
Populate R29 and R28 for no curent amplification
Vout
