Ian-Blockmans/efuse/panel/BOTTOM Drawing v1.pdf

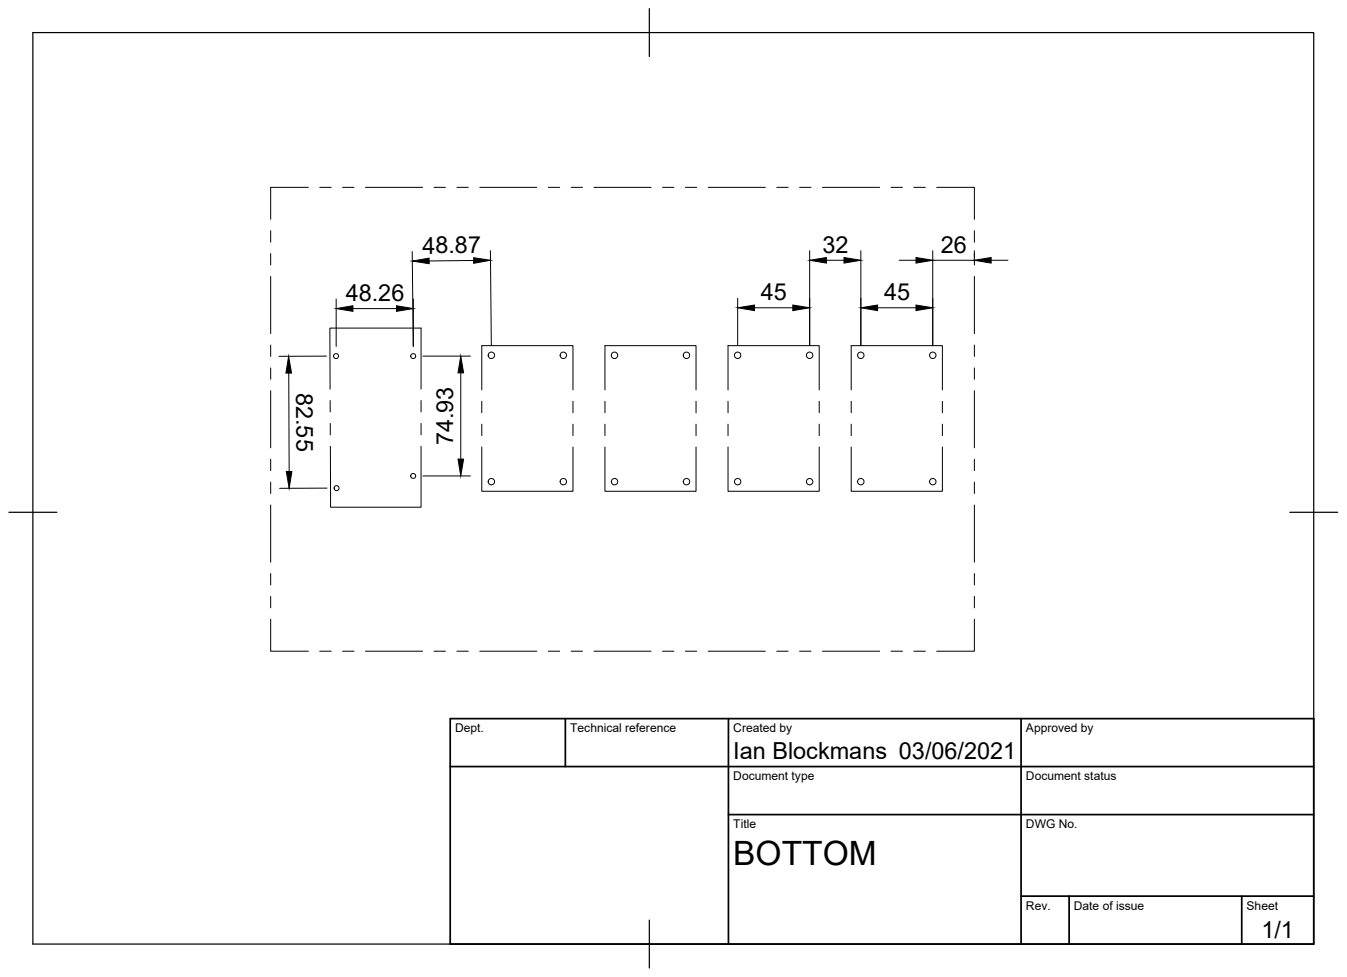
[picture p85: page 1]

Dept. | Technical reference | Created by Ian Blockmans 03/06/2021 | Approved by

Document type | Document status

Title BOTTOM | DWG No.

Rev. | Date of issue | Sheet 1/1
