Ian-Blockmans/efuse/panel/panel Drawing v1 buitenkant.pdf

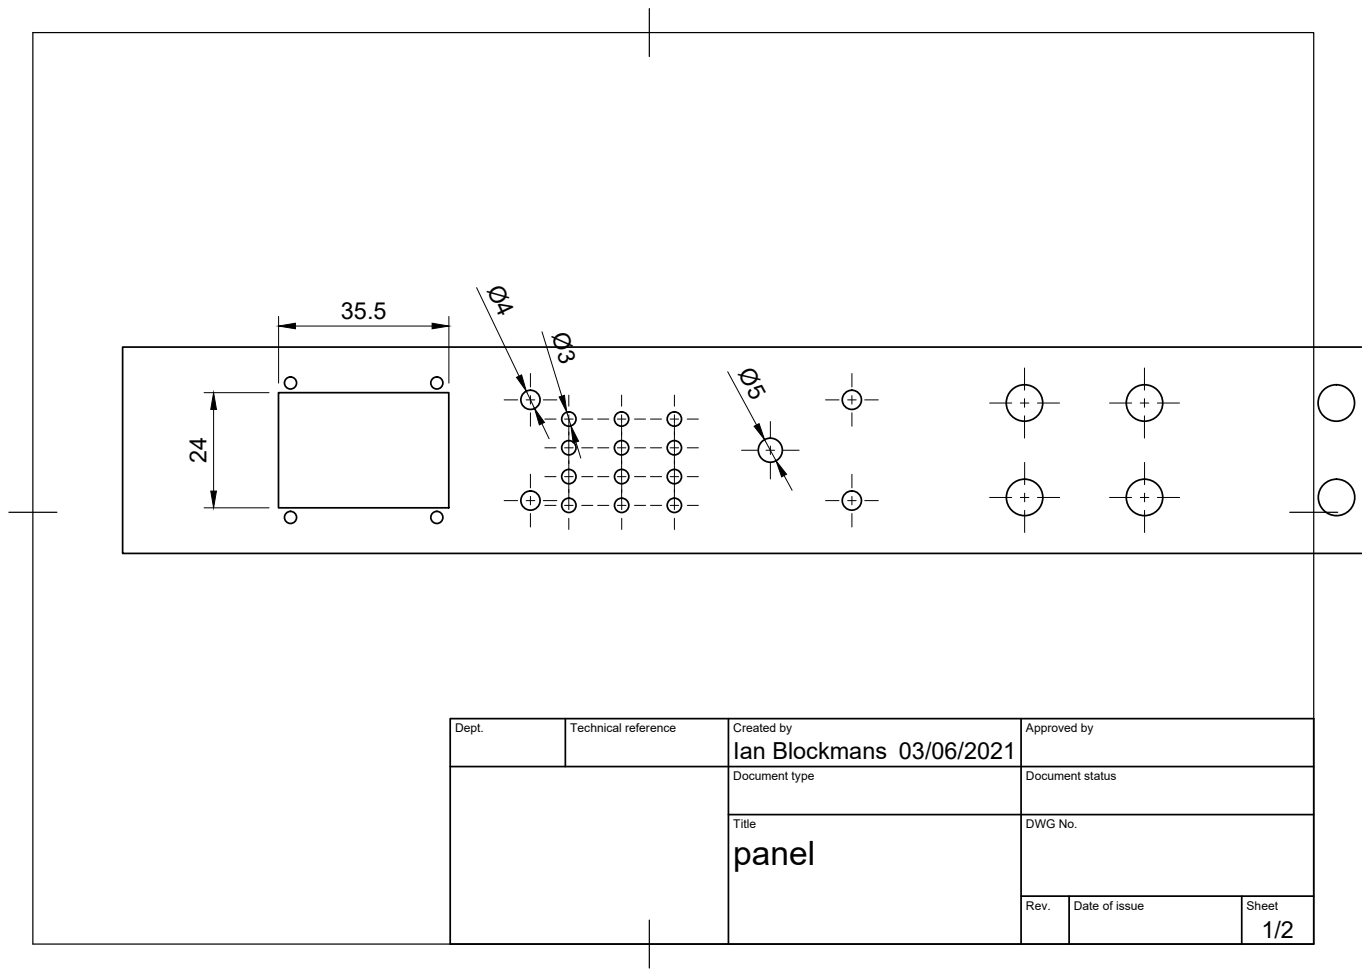
[picture p86: page 1]

Dept. | Technical reference | Created by Ian Blockmans 03/06/2021 | Approved by

Document type | Document status

Title panel | DWG No.

Rev. | Date of issue | Sheet 1/2

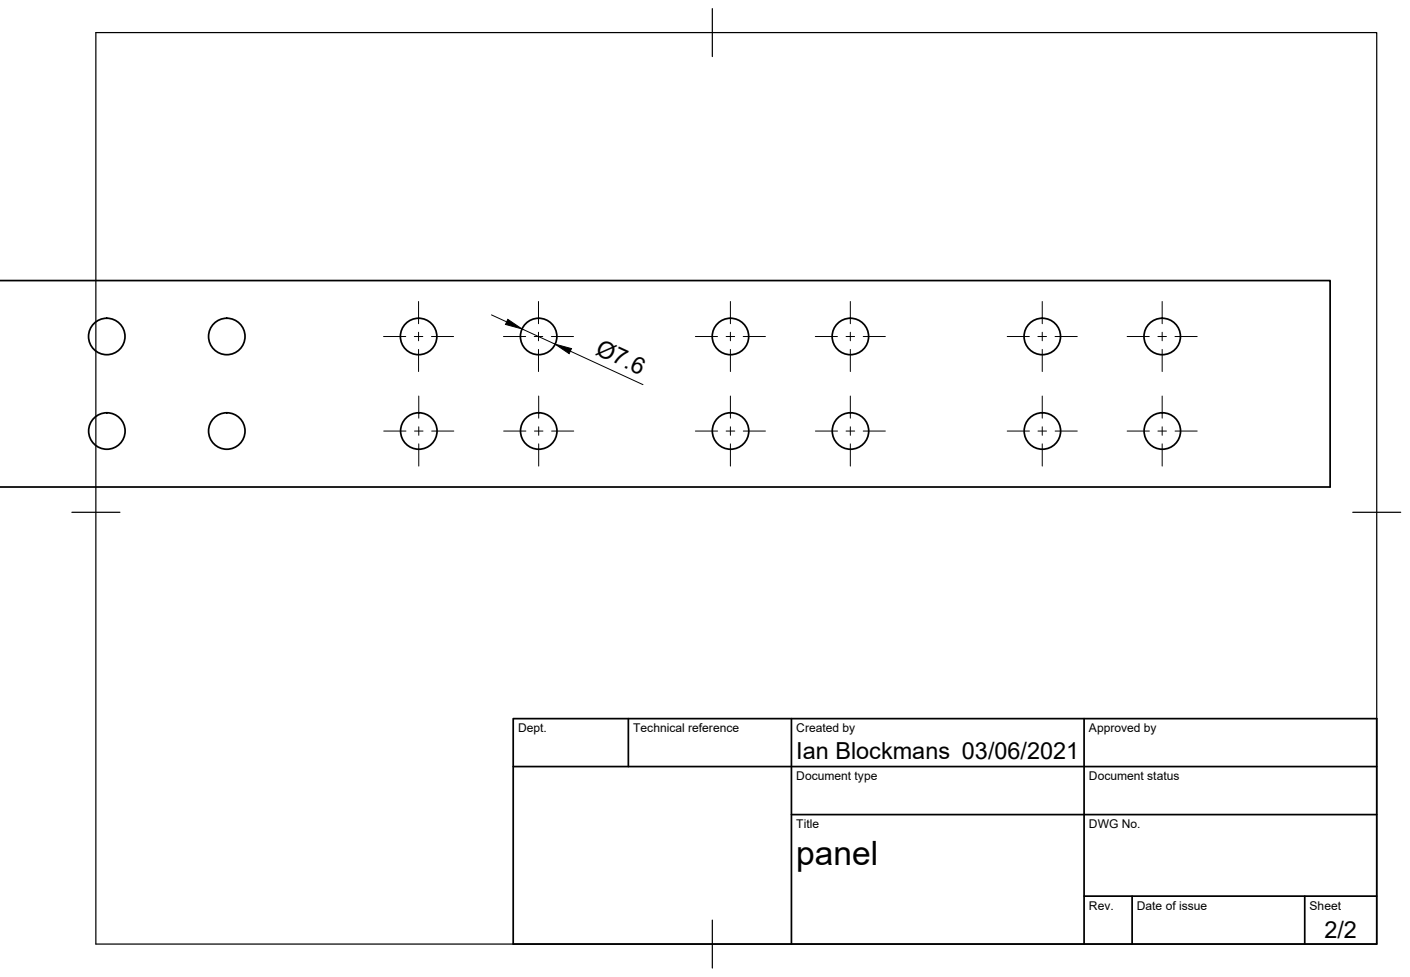
[picture p87: page 2]

Dept. | Technical reference | Created by Ian Blockmans 03/06/2021 | Approved by

Document type | Document status

Title panel | DWG No.

Rev. | Date of issue | Sheet 2/2
