Ian-Blockmans/efuse/overige documenten/Composite Drawing.pdf

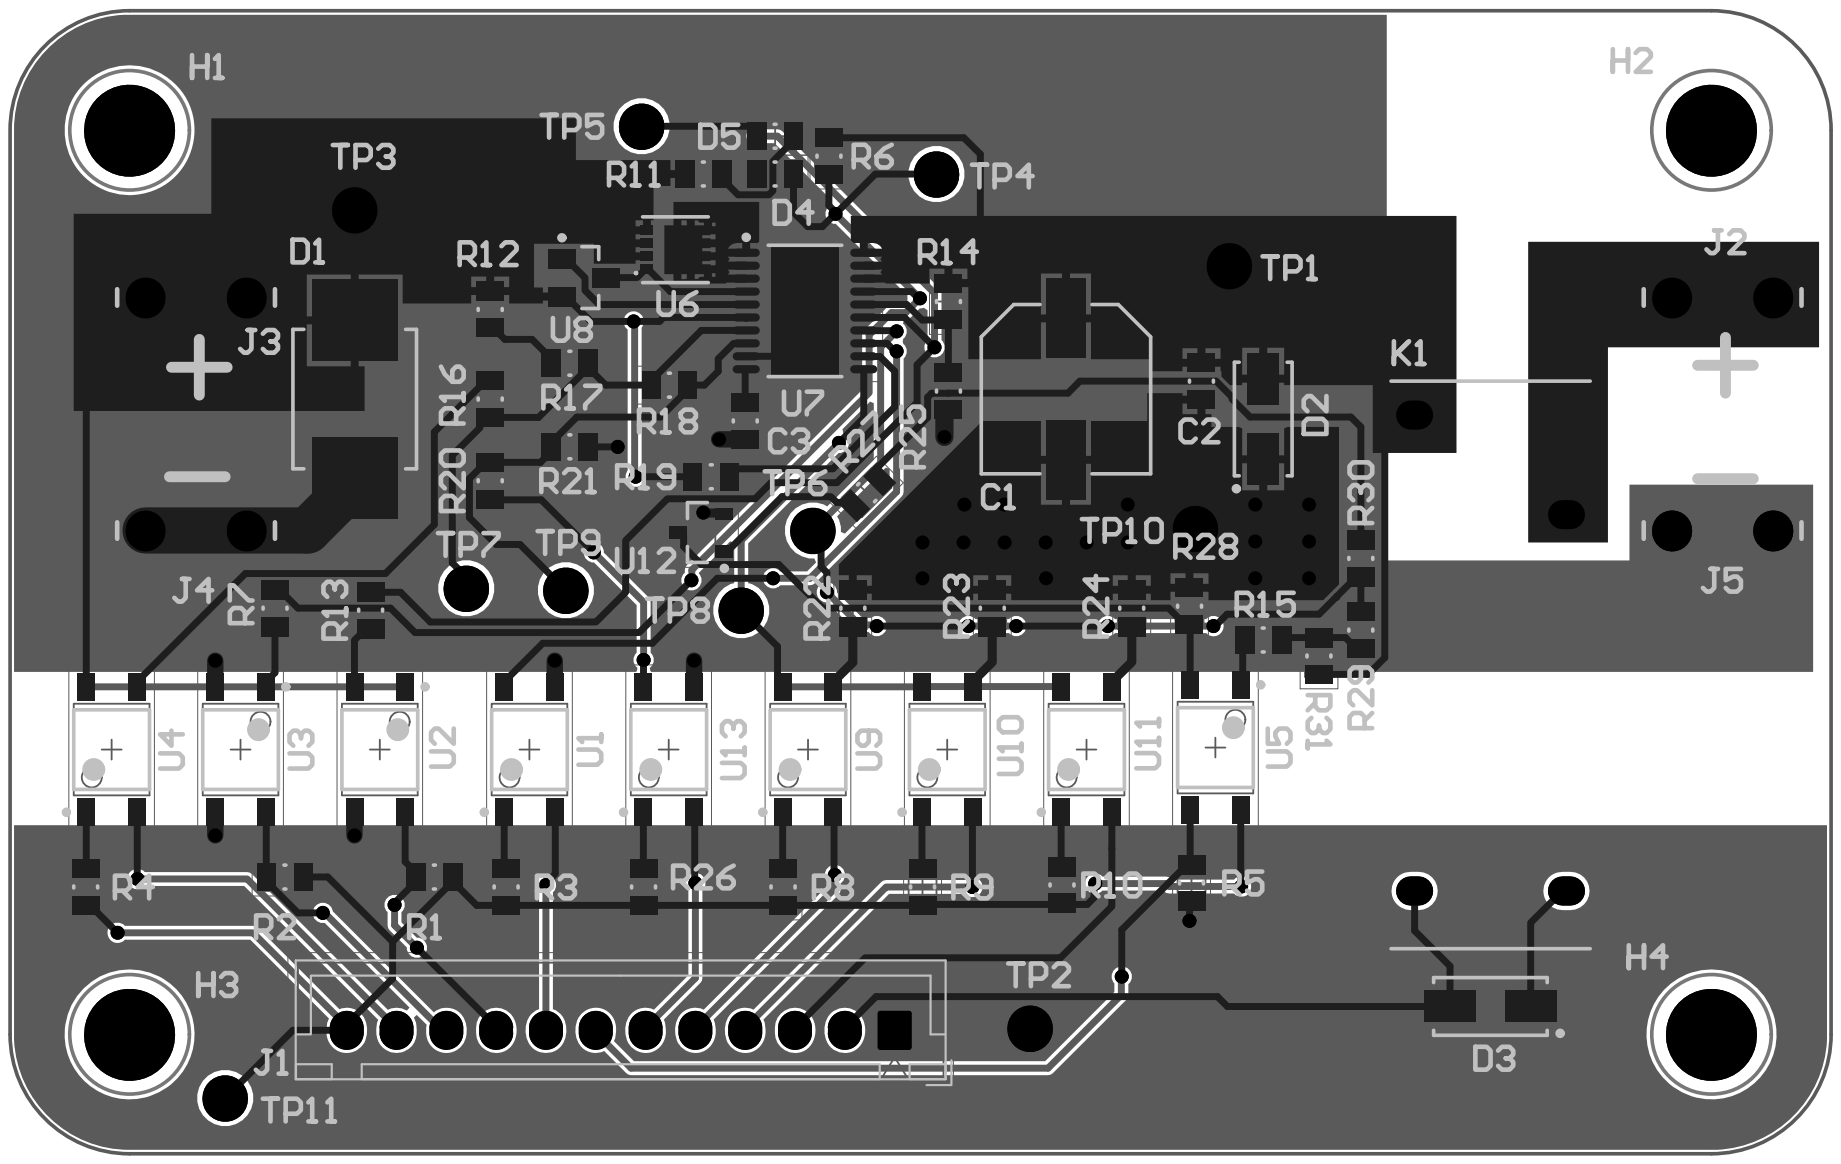
[picture p88: page 1]
