Ian-Blockmans/efuse/(list of files, drawings)

Other design files:
pcb/controll_board/controll_board.PrjPcb
pcb/efuse/controller.SchDoc
pcb/efuse/Digital.SchDoc
pcb/efuse/efuse.PrjPcb
pcb/efuse/eFuse_proto1.PcbDoc
pcb/efuse/efuseV0.2.PcbDoc
pcb/efuse/fuse.SchDoc
pcb/efuse/top.SchDoc
pcb/efuse/UI.SchDoc
pcb/front_panel/front pannel.PcbDoc
pcb/front_panel/front_panel.PrjPcb
pcb/fuse_old.SchDoc
