Ian-Blockmans/efuse/(commit log)

2021-02-24 schema update
    [Digital_Signaling.SchDoc, efuse.PrjPcb, fuse.SchDoc, signaling.SchDoc, top.SchDoc]
2021-02-25 added tradeoff's
    [efuse.PrjPcb]
2021-03-01 documenten toegevoegd + schema update
    planning + weerstand berekening+ tradeoffs update + schema weerstanden spannings instellingen
    [fuse.SchDoc]
2021-03-02 Create Evalutiebord tps266600 inrush current.docx
2021-03-05 Update Evalutiebord tps26600 inrush current.docx
2021-03-07 update schemas + documenten
    Footprints toegevoegd voor quick disconnect en optocoupler. weekverslag 2 geupload en 3 gestart
    [Digital_Signaling.SchDoc, fuse.SchDoc, top.SchDoc]
2021-03-09 schema+pcb update
    [eFuse_proto1.PcbDoc, efuse.PrjPcb, fuse.SchDoc, top.SchDoc]
2021-03-13 schema + pcb + temp bom
    [Bom_8566688.xlsx, Digital.SchDoc, Digital_Signaling.SchDoc, eFuse_proto1.PcbDoc, eFuse_proto1.step, efuse.PrjPcb, fuse.SchDoc, fuse_old.SchDoc]
2021-03-13 altium project save
    [efuse.PrjPcb]
2021-03-13 schema + pcb update
    [Digital.SchDoc, eFuse_proto1.PcbDoc]
2021-03-13 document update
    [Digital.SchDoc]
2021-03-13 ignore .tmp
    [Digital.SchDoc]
2021-03-18 schema + document update
    [Bom_8566688.xlsx, Digital.SchDoc, eFuse_proto1.PcbDoc, fuse.SchDoc, top.SchDoc]
2021-03-31 final proto
    [Digital.SchDoc, eFuse_proto1.PcbDoc, efuse.PrjPcb, fuse.SchDoc]
2021-04-01 added document + pull up for mosfet
    [Digital.SchDoc, eFuse_proto1.PcbDoc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]
2021-04-02 pcb final + bom
    [Bom_8566688.xlsx, Bom_efuse.csv, eFuse_proto1.PcbDoc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]
2021-04-12 software update LabVIEW en Arduino
    [Digital.SchDoc]
2021-04-29 software update for prototype
2021-04-29 under volt and overvolt test result
2021-04-30 relay switchoff + time analysis
2021-05-04 added nano test code
    [Digital.SchDoc, DigitalV0.1.SchDoc, efuse.PrjPcb, fuse.SchDoc, fuseV0.1.SchDoc, top.SchDoc, topV0.1.SchDoc]
2021-05-04 V0.1 pcb
    [Digital.SchDoc, DigitalV0.1.SchDoc, efuse.PrjPcb, fuse.SchDoc, fuseV0.1.SchDoc, top.SchDoc, topV0.1.SchDoc]
2021-05-04 create controller sheet
    [controller.SchDoc]
2021-05-04 digital + ui schema
    [Digital.SchDoc, UI.SchDoc, controller.SchDoc, efuse.PrjPcb, fuse.SchDoc, top.SchDoc]
2021-05-06 software + pcb update
    [UI.SchDoc, controller.SchDoc, fuse.SchDoc]
2021-05-11 pcbs almost done
    [UI.SchDoc, controll_board.PrjPcb, controller.PcbDoc, controller.SchDoc, efuse.PrjPcb, front pannel.PcbDoc, front_panel.PrjPcb, top.SchDoc]
2021-05-18 thesis update + pcb
    [Digital.SchDoc, UI.SchDoc, controll_board.PrjPcb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]
2021-05-25 software update to arduino due
2021-05-26 folder cleenup
    [Bom_efuse.csv, eFuse_proto1.step]
2021-05-26 led symmetry fix
    [front pannel.PcbDoc]
2021-05-26 document + pcb gerber update
    [front pannel_Copper_Signal_Bot.gbr, front pannel_Copper_Signal_Top.gbr, front pannel_Drawing_1.gbr, front pannel_Drillmap_1.gbr, front pannel_Legend_Bot.gbr, front pannel_Legend_Top.gbr, front pannel_Mechanical_1.gbr, front pannel_NPTH_Drill.gbr]
2021-06-16 file updates that did not change anything
    [efuseV0.2.PcbDoc]
